PasanWLS/PC-Oscilloscope/Analog Front-end 3D view.png

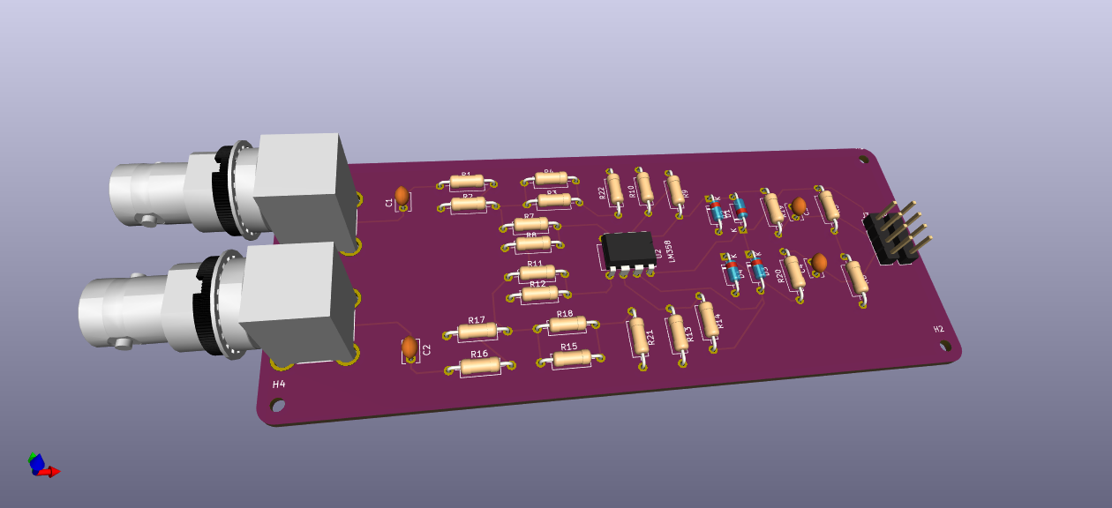
Analog Front-end 3D view.png
