PasanWLS/PC-Oscilloscope/Main PCB 3D view.png

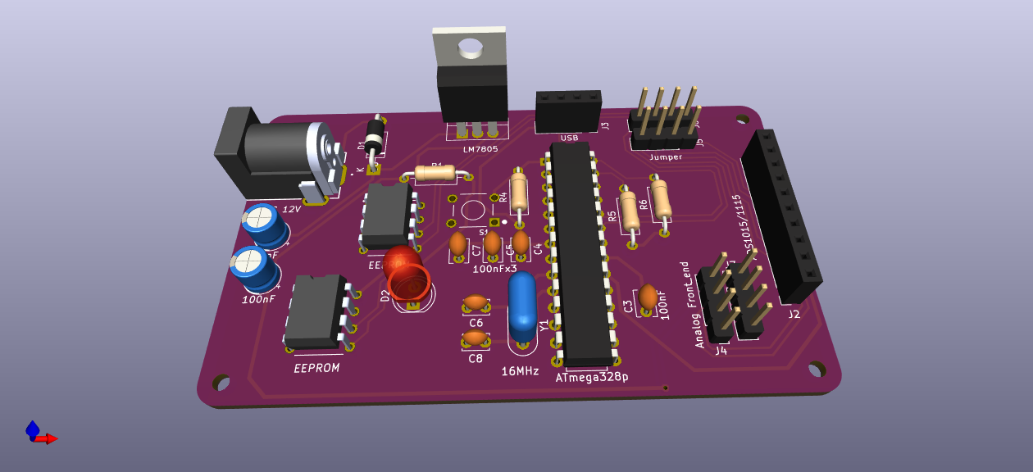
Main PCB 3D view.png
