PasanWLS/PC-Oscilloscope/README.md

# PC-Oscilloscope
PC Oscilloscope designing
this is our 3rd year final project, pc oscilloscope
