PasanWLS/PC-Oscilloscope/Ana;og Front-end 2D.png

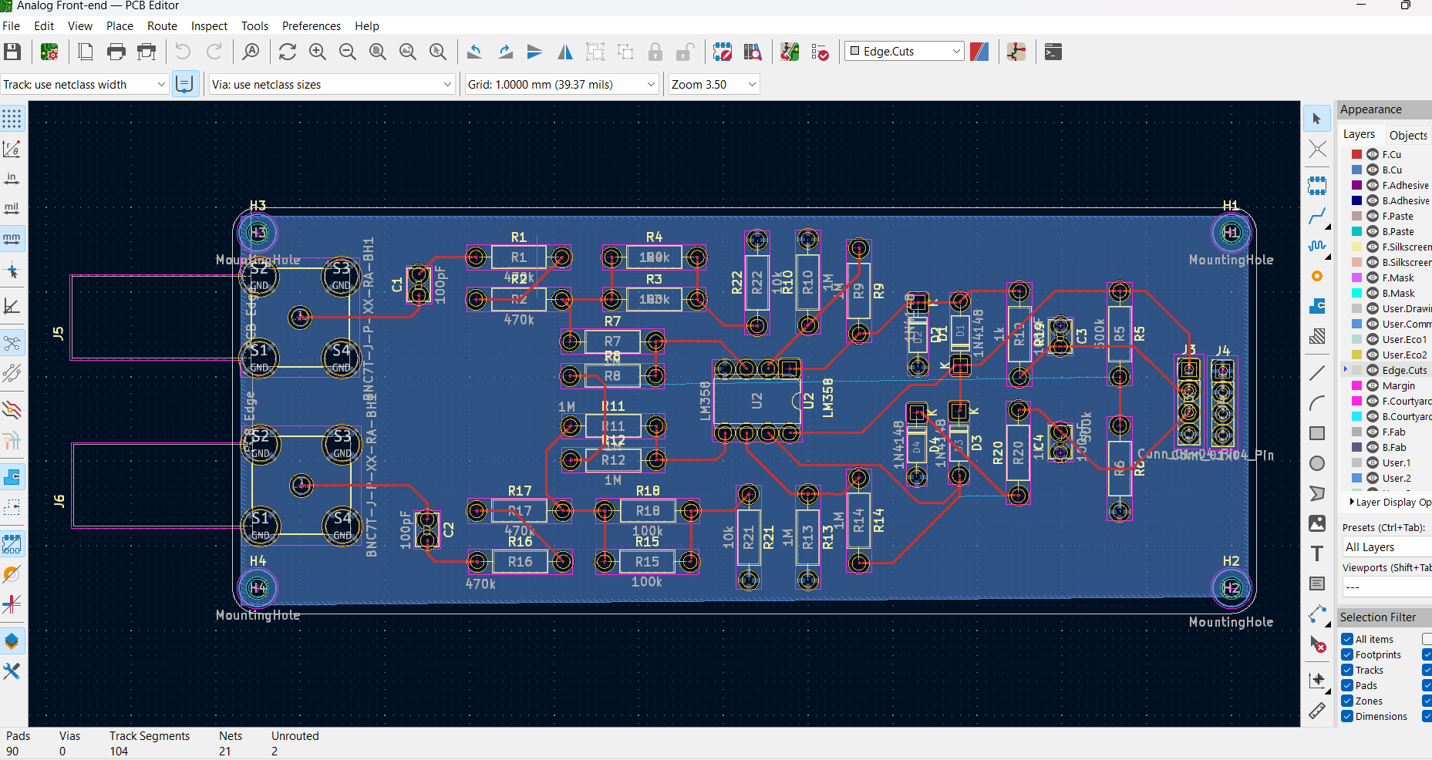
Ana;og Front-end 2D.png
