PasanWLS/PC-Oscilloscope/Analog Front-end Schematic Diagram.jpg

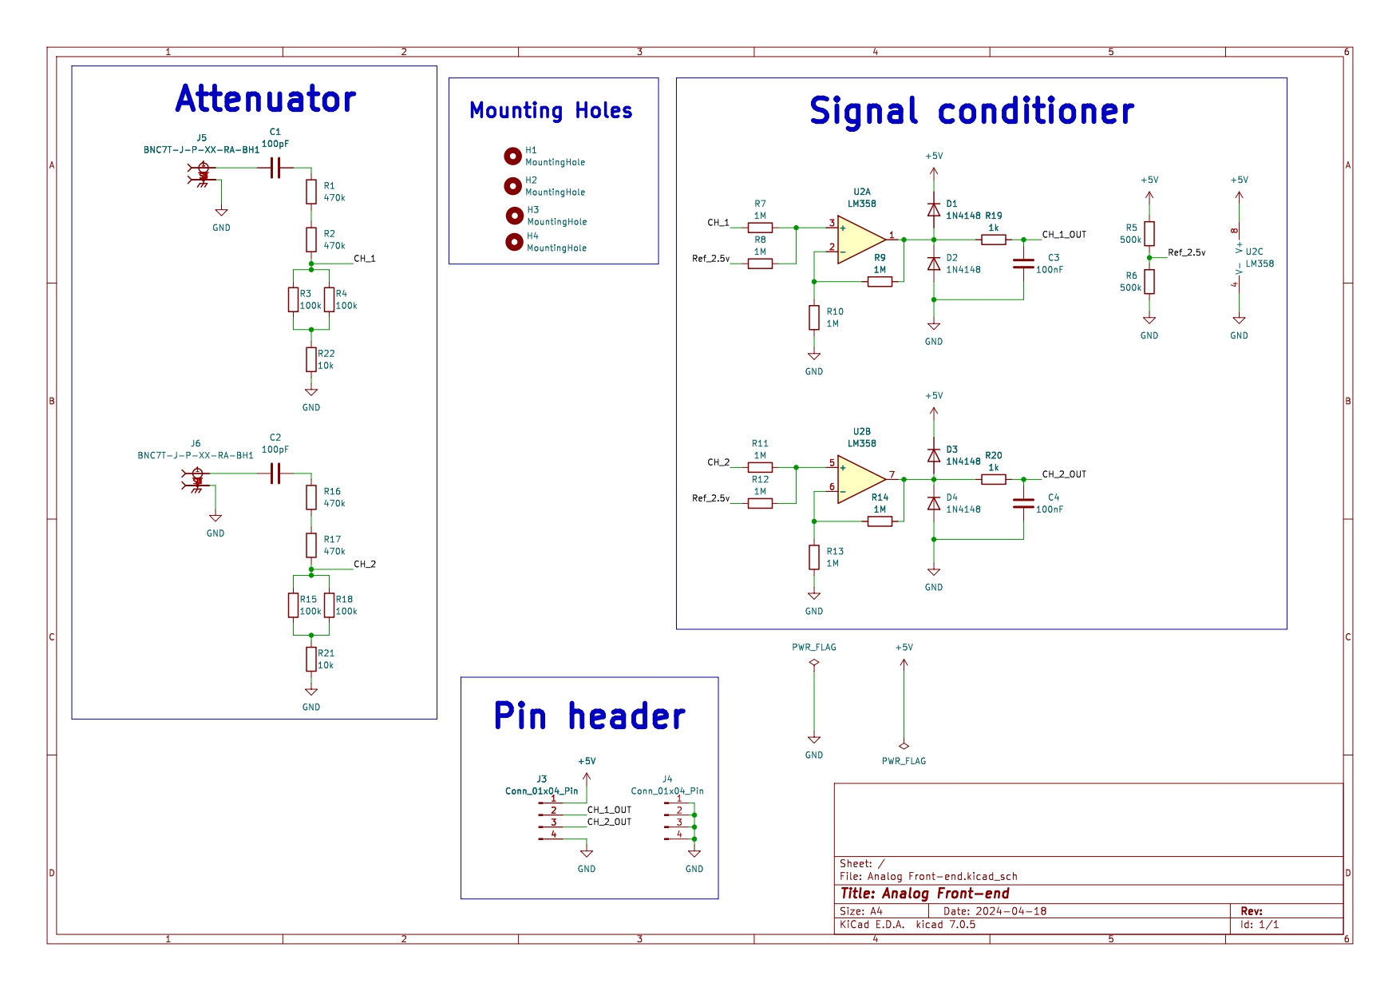
Analog Front-end Schematic Diagram.jpg
