PasanWLS/PC-Oscilloscope/Main PCB Schematic Diagram.jpg

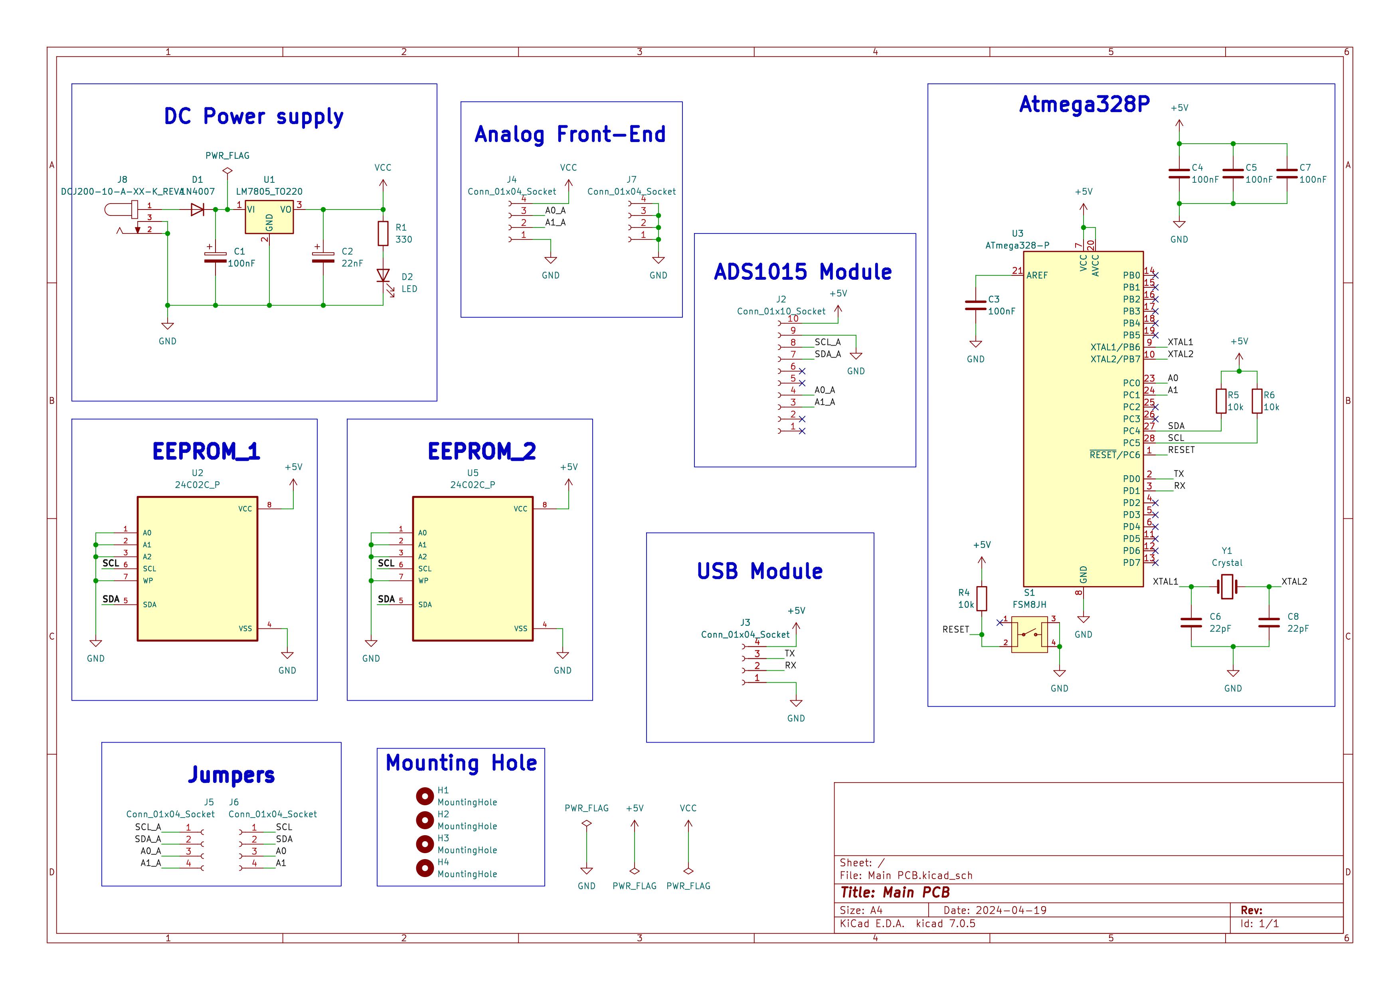
Main PCB Schematic Diagram.jpg
