PasanWLS/PC-Oscilloscope/Main PCB_2D.png

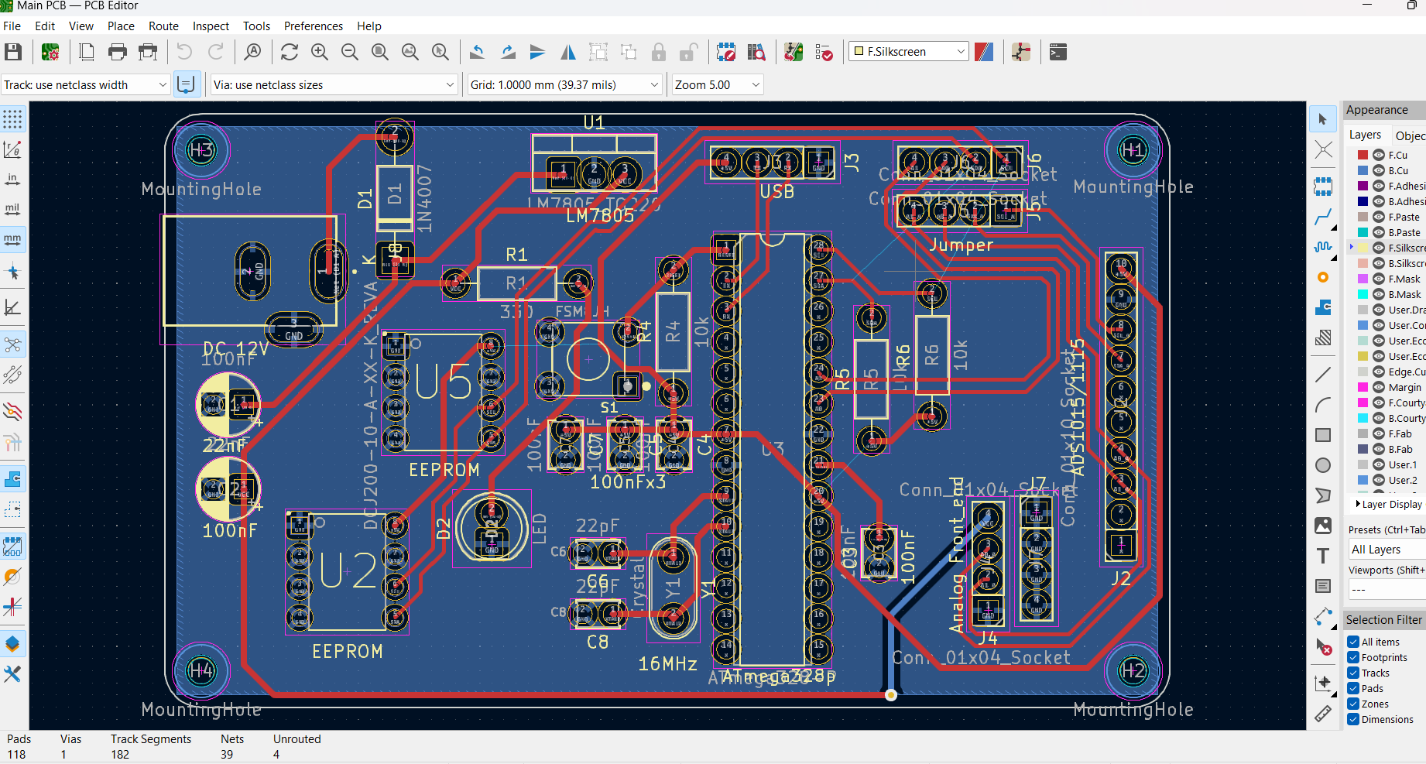
Main PCB_2D.png
