PasanWLS/PC-Oscilloscope/PC Application GUI.JPG

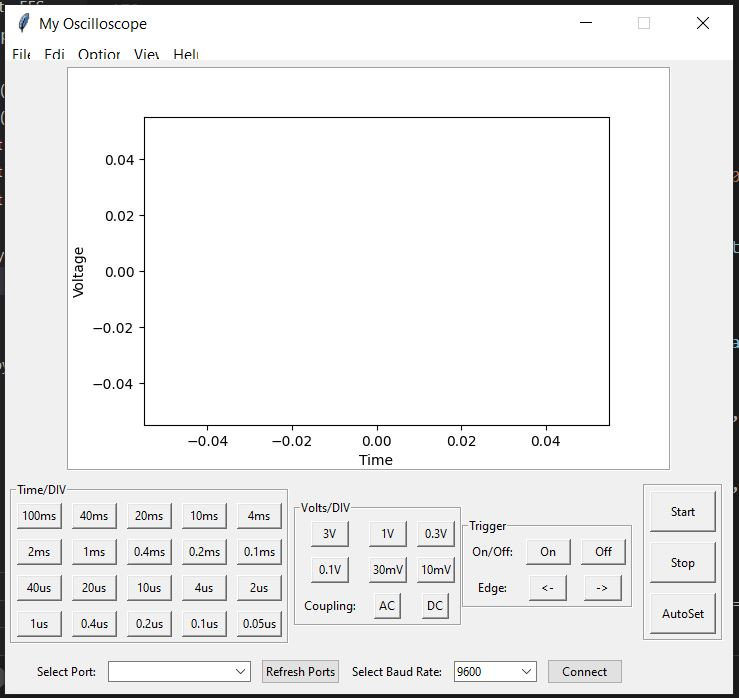
PC Application GUI.JPG
