PasanWLS/PC-Oscilloscope/Footprint/24C02C_P/24C02C_P.STEP

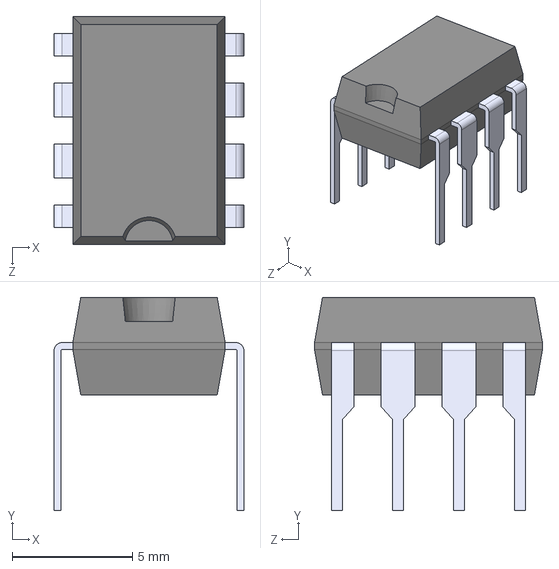
[picture p8: CAD file, 2024-06-17]
Footprint/24C02C_P/24C02C_P.STEP
7.91 x 8.89 x 9.50 mm
