PasanWLS/PC-Oscilloscope/Footprint/BNC7T-J-P-XX-RA-BH1/BNC7T-J-P-HN-RA-BH1.stp

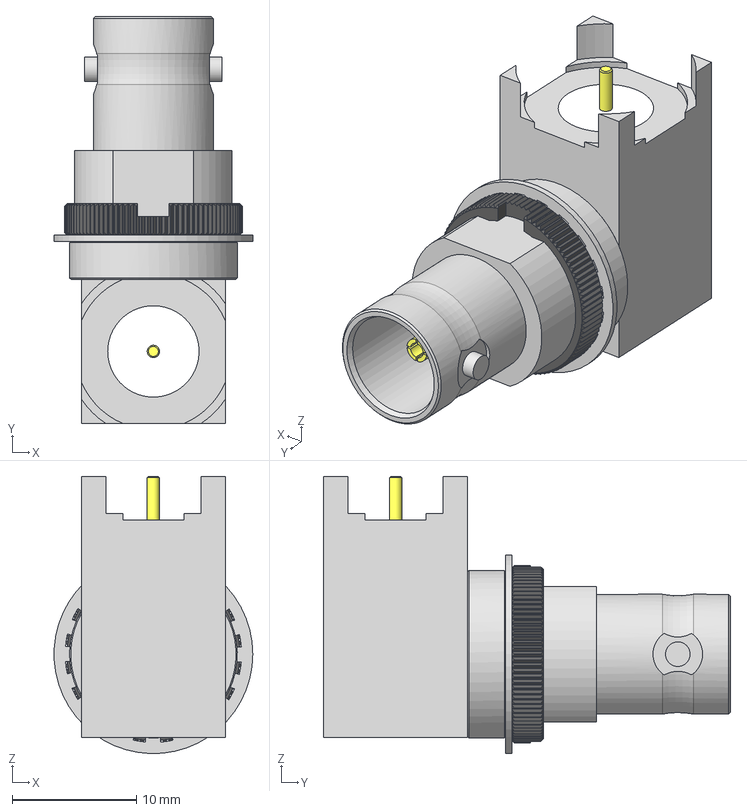
[picture p9: CAD file, 2024-06-17]
Footprint/BNC7T-J-P-XX-RA-BH1/BNC7T-J-P-HN-RA-BH1.stp
16.0 x 32.8 x 22.3 mm
BNC7T-G-P-HN-RA-BH1_s
BNC7T-G-P-HN-RA-BH1_i
BNC7T-G-P-HN-RA-BH1_p
BNC7T-G-P-HN-RA-BH1_w
BNC7T-G-P-HN-RA-BH1_n
