PasanWLS/PC-Oscilloscope/Footprint/DCJ200-10-A-XX-K_REVA/DCJ200-10-A-K1-K--3DModel-STEP-740395.STEP

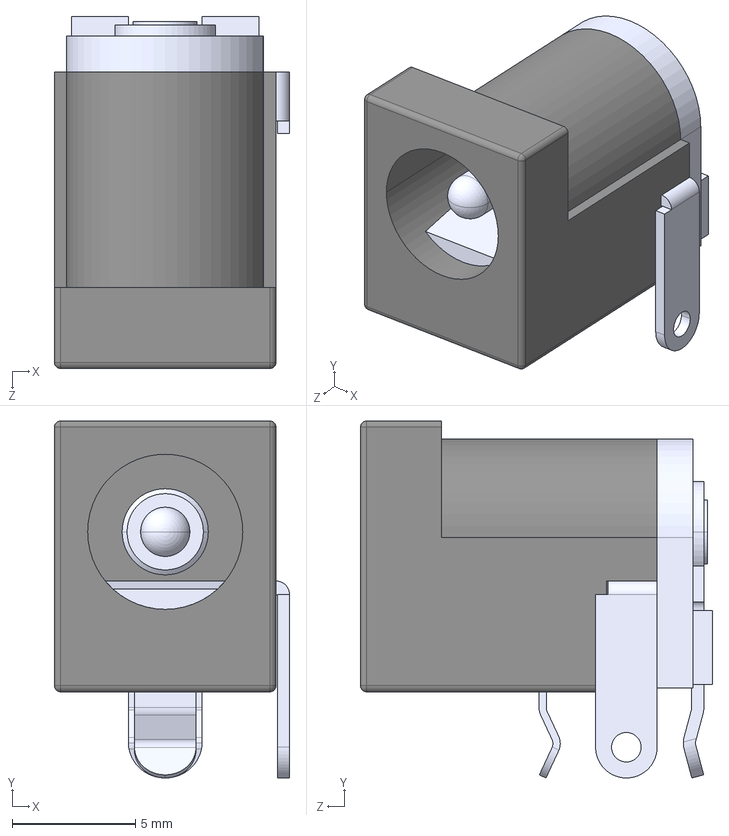
[picture p10: CAD file, 2024-06-17]
Footprint/DCJ200-10-A-XX-K_REVA/DCJ200-10-A-K1-K--3DModel-STEP-740395.STEP
9.55 x 14.5 x 14.3 mm
