PasanWLS/PC-Oscilloscope/Oscilloscope/Analog Front-end/Analog Front-end.kicad_pcb

## KiCad design Oscilloscope/Analog Front-end/Analog Front-end.kicad_pcb (2024-06-17)

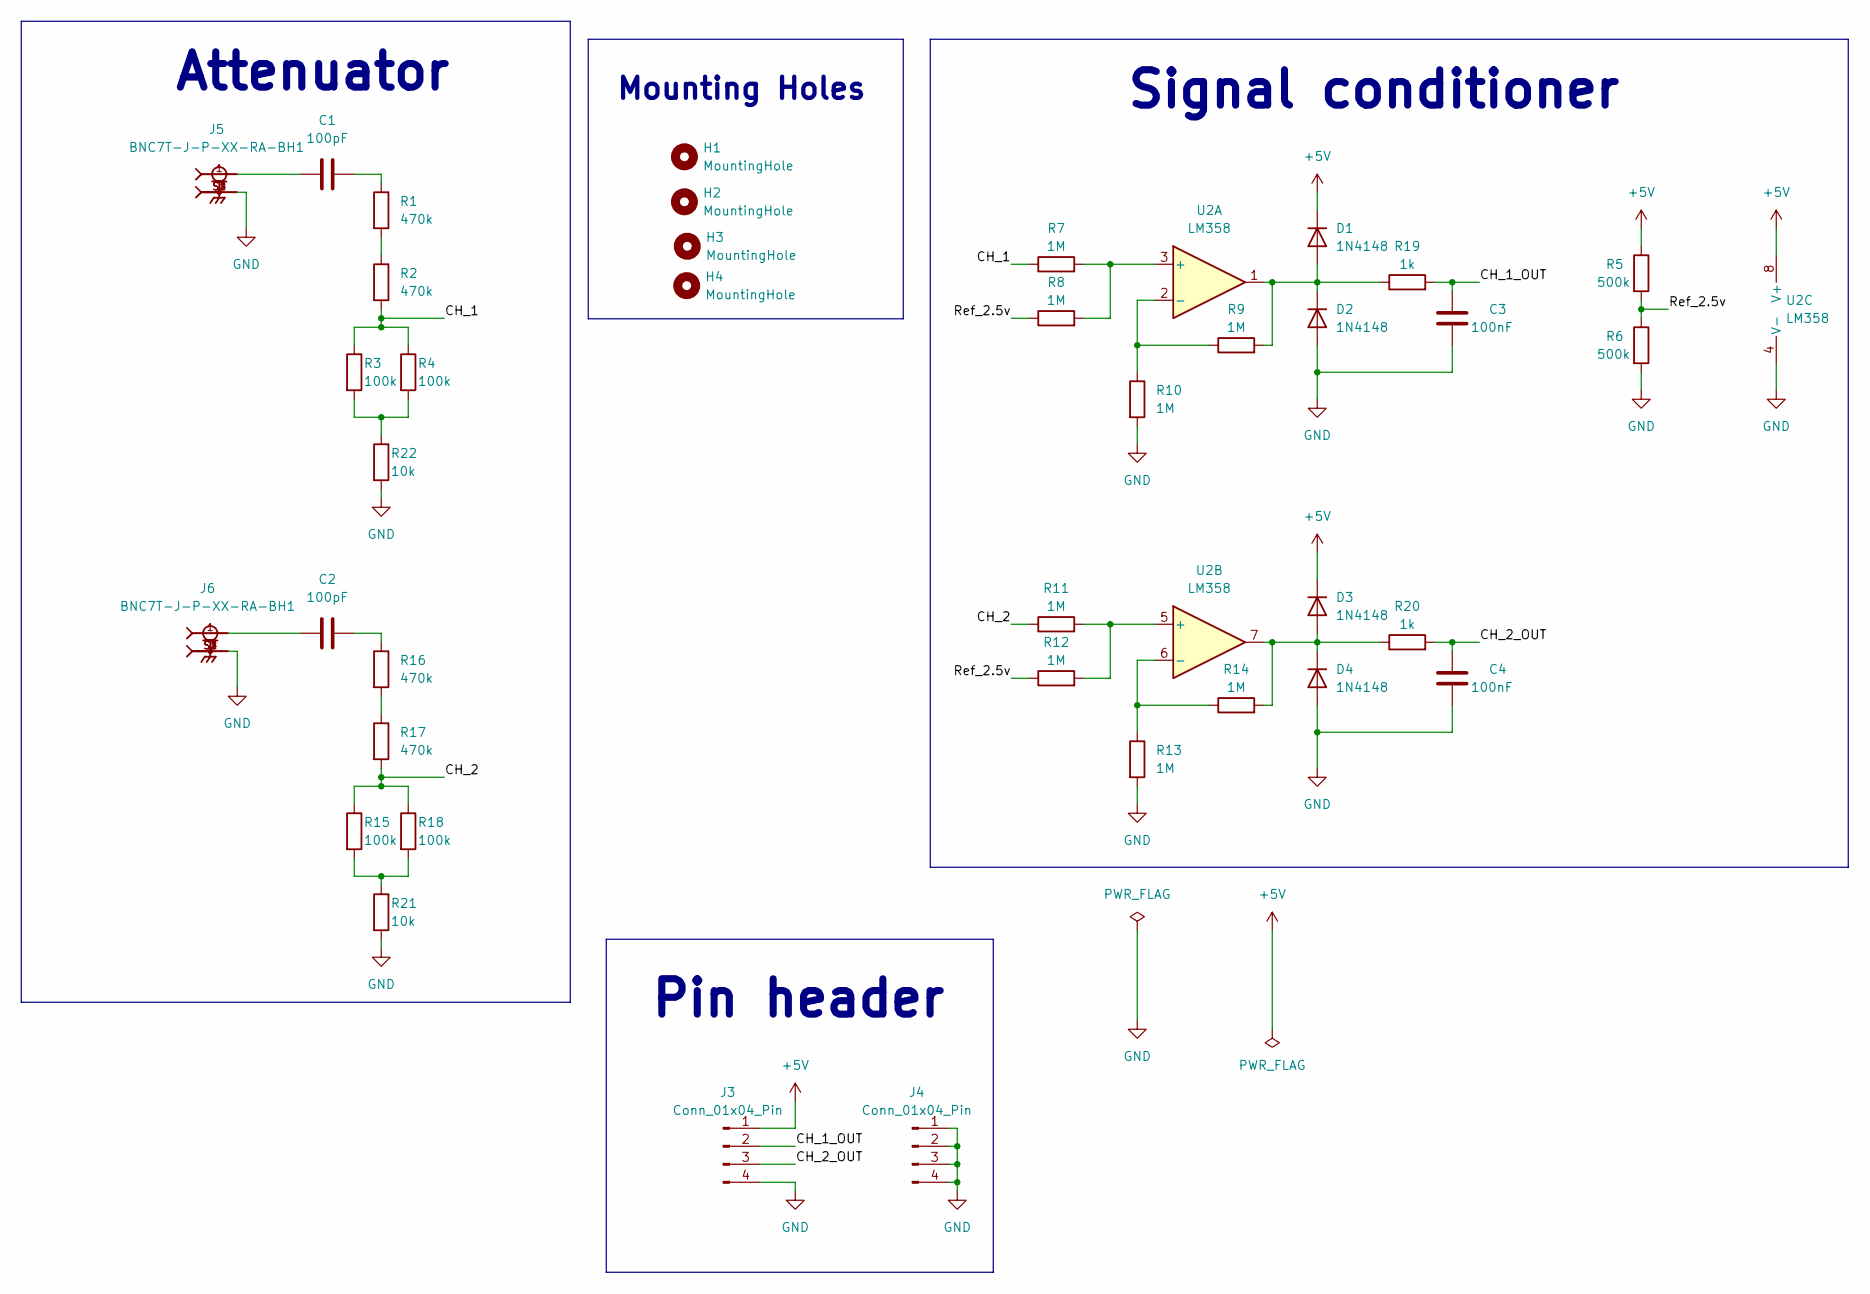
[picture p11: schematic Analog Front-end.kicad_sch]

Parts:
C1, C2: 100pF; C_Disc_D3.8mm_W2.6mm_P2.50mm
C3, C4: 100nF; C_Disc_D3.8mm_W2.6mm_P2.50mm
D1, D2, D3, D4: 1N4148; D_DO-35_SOD27_P7.62mm_Horizontal
H1, H2, H3, H4: MountingHole; MountingHole_2.2mm_M2
J3, J4: Conn_01x04_Pin; PinHeader_1x04_P2.54mm_Vertical
J5, J6: BNC7T-J-P-XX-RA-BH1; SAMTEC_BNC7T-J-P-XX-RA-BH1; PARTREV G
R1, R2, R16, R17: 470k; R_Axial_DIN0207_L6.3mm_D2.5mm_P10.16mm_Horizontal
R3, R4, R15, R18: 100k; R_Axial_DIN0207_L6.3mm_D2.5mm_P10.16mm_Horizontal
R5, R6: 500k; R_Axial_DIN0207_L6.3mm_D2.5mm_P10.16mm_Horizontal
R7, R8, R9, R10, R11, R12, R13, R14: 1M; R_Axial_DIN0207_L6.3mm_D2.5mm_P10.16mm_Horizontal
R19, R20: 1k; R_Axial_DIN0207_L6.3mm_D2.5mm_P10.16mm_Horizontal
R21, R22: 10k; R_Axial_DIN0207_L6.3mm_D2.5mm_P10.16mm_Horizontal
U2: LM358; DIP-8_W7.62mm

Connections:
+5V: D1.1 (K), D3.1 (K), J3.1, R5.1, U2.8 (V+)
/CH_1: R2.2, R3.1, R4.1, R7.1
/CH_1_OUT: C3.2, J3.2, R19.2
/CH_2: R11.1, R15.1, R17.2, R18.1
/CH_2_OUT: C4.2, J3.3, R20.2
/Ref_2.5v: R5.2, R6.1, R8.1, R12.1
GND: C3.1, C4.1, D2.2 (A), D4.2 (A), J3.4, J4.1, J4.2, J4.3, J4.4, J5.S1, J5.S2, J5.S3, J5.S4, J6.S1, J6.S2, J6.S3, J6.S4, R6.2, R10.2, R13.2, R21.2, R22.2, U2.4 (V-)
unnamed: C1.1, J5.1
unnamed: C1.2, R1.1
unnamed: C2.1, J6.1
unnamed: C2.2, R16.1
unnamed: D1.2 (A), D2.1 (K), R9.2, R19.1, U2.1
unnamed: D3.2 (A), D4.1 (K), R14.2, R20.1, U2.7
unnamed: R1.2, R2.1
unnamed: R15.2, R18.2, R21.1
unnamed: R16.2, R17.1
unnamed: R3.2, R4.2, R22.1
unnamed: R7.2, R8.2, U2.3 (+)
unnamed: R9.1, R10.1, U2.2 (-)
unnamed: R11.2, R12.2, U2.5 (+)
unnamed: R13.1, R14.1, U2.6 (-)

Notes on the sheet:
Mounting Holes
Signal conditioner
Attenuator
Pin header

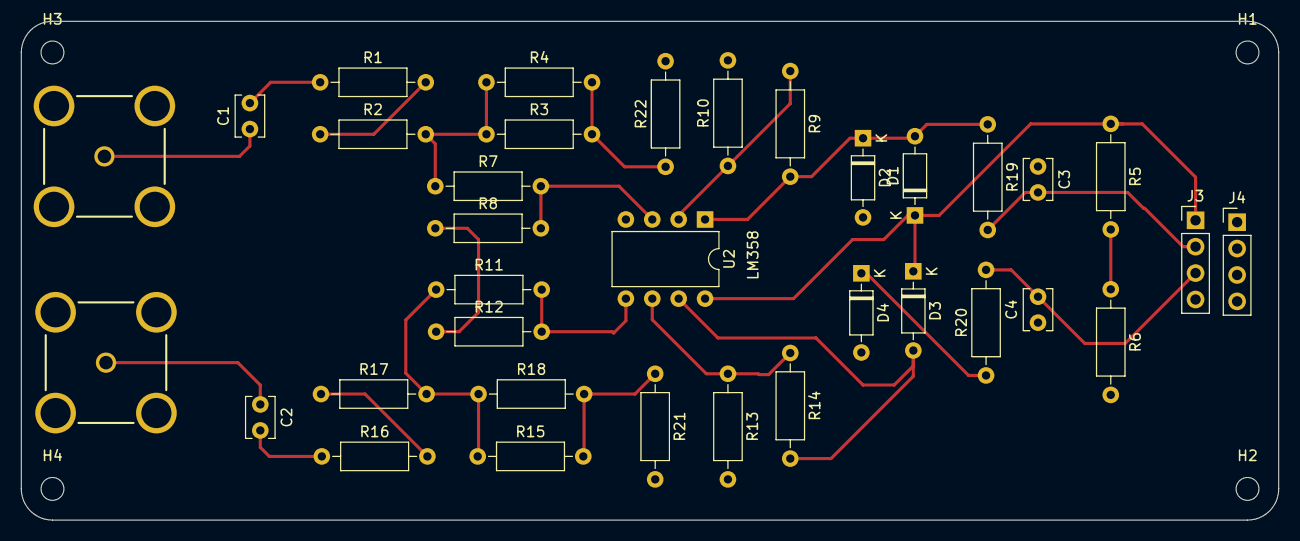
[picture p12: board Analog Front-end.kicad_pcb from above]

Board: 2 copper layers, 121.0 x 48.0 mm, 39 parts (0 on the bottom side), 21 nets.
