PasanWLS/PC-Oscilloscope/Oscilloscope/Main PCB/Main PCB.kicad_pcb

## KiCad design Oscilloscope/Main PCB/Main PCB.kicad_pcb (2024-06-17)

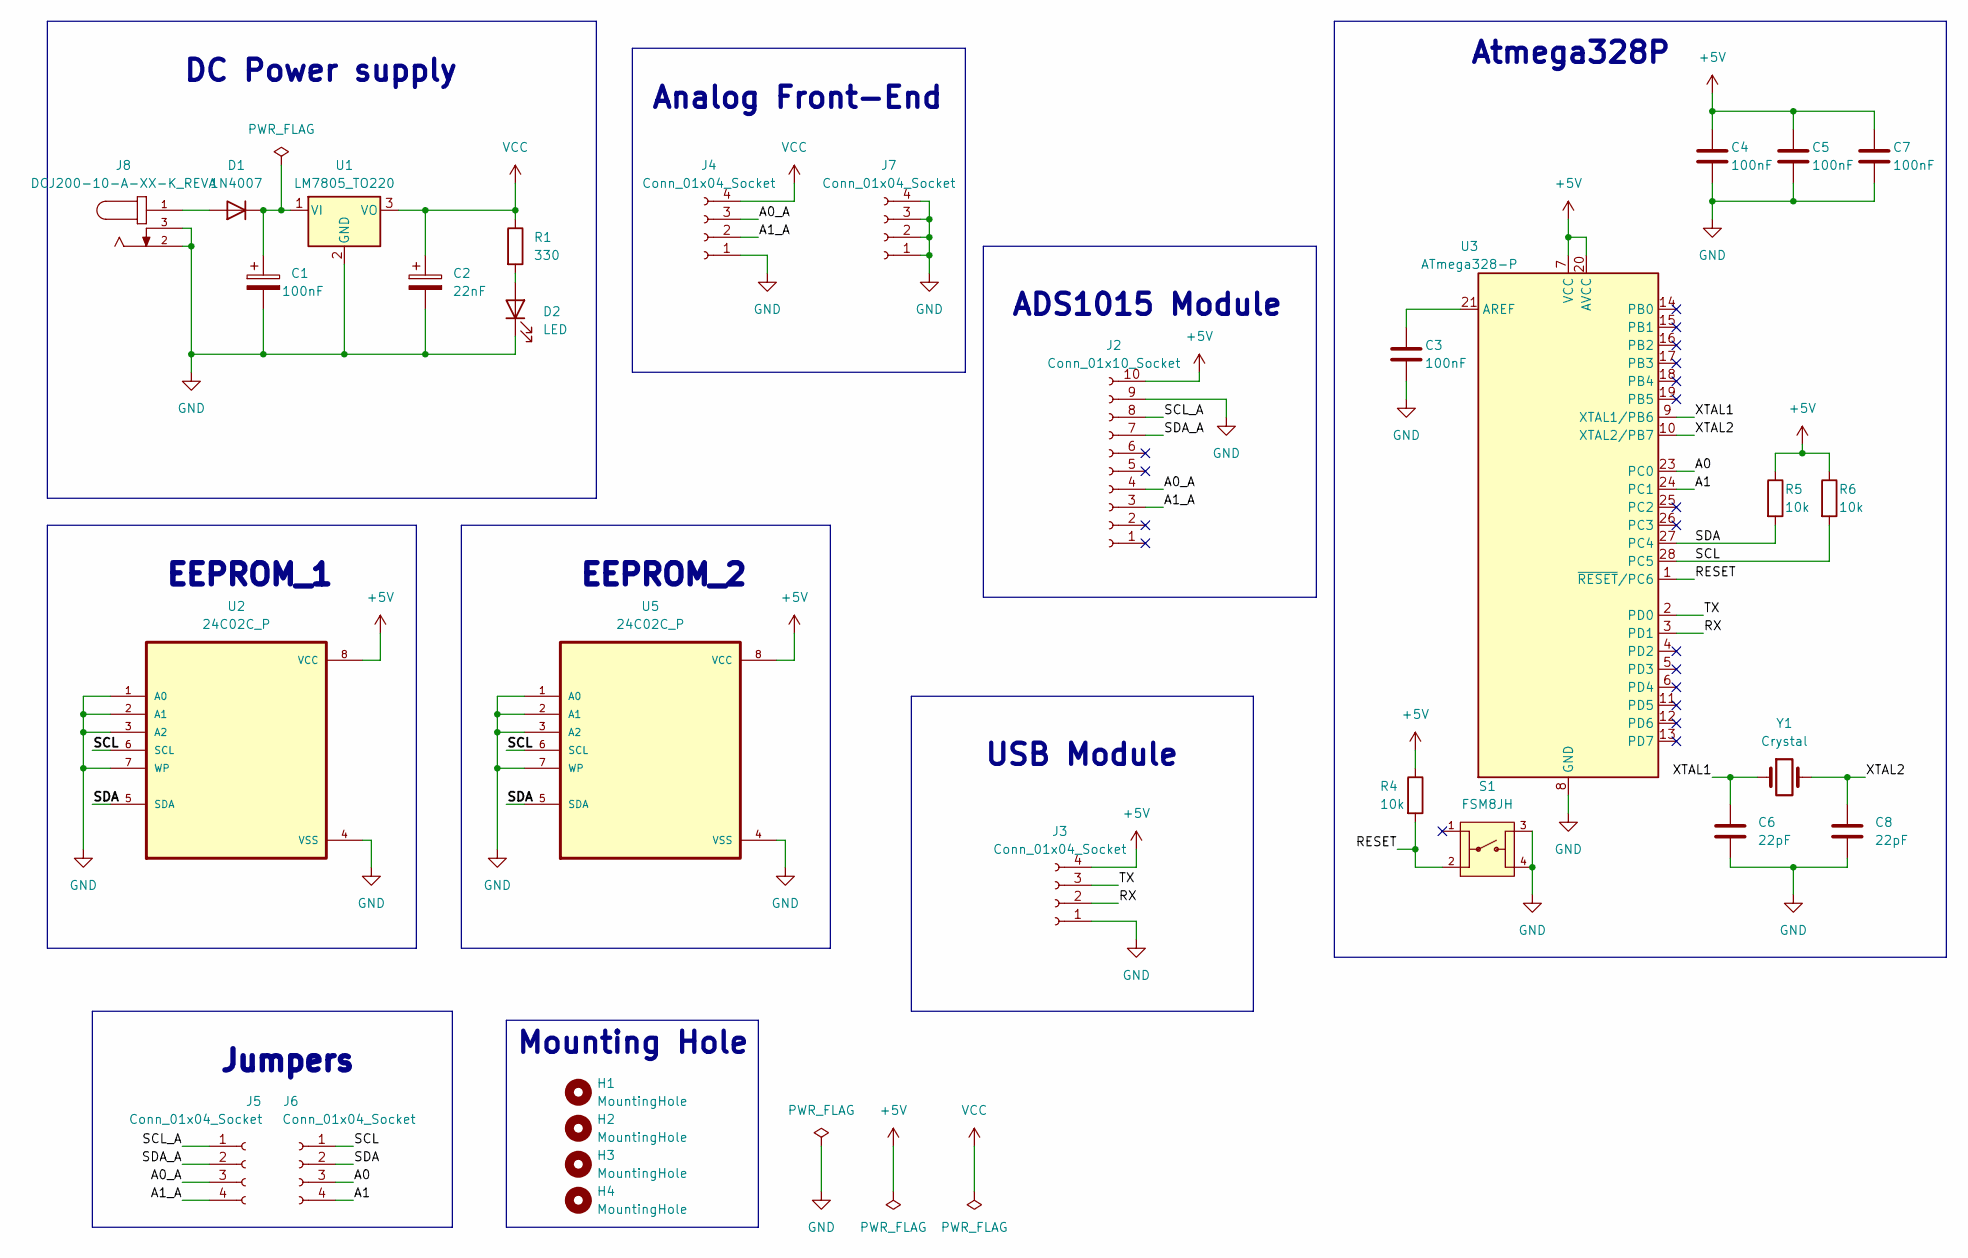
[picture p13: schematic Main PCB.kicad_sch]

Parts:
C1: 100nF; CP_Radial_D5.0mm_P2.50mm
C2: 22nF; CP_Radial_D5.0mm_P2.50mm
C3, C4, C5, C7: 100nF; C_Disc_D3.8mm_W2.6mm_P2.50mm
C6, C8: 22pF; C_Disc_D3.4mm_W2.1mm_P2.50mm
D1: 1N4007; D_DO-41_SOD81_P10.16mm_Horizontal
D2: LED; LED_D5.0mm
H1, H2, H3, H4: MountingHole; MountingHole_2.2mm_M2
J2: Conn_01x10_Socket; PinSocket_1x10_P2.54mm_Vertical
J3: Conn_01x04_Socket; PinSocket_1x04_P2.54mm_Vertical
J4, J5, J6, J7: Conn_01x04_Socket; PinHeader_1x04_P2.54mm_Vertical
J8: DCJ200-10-A-XX-K_REVA; GCT_DCJ200-10-A-XX-K_REVA; PARTREV A
R1: 330; R_Axial_DIN0207_L6.3mm_D2.5mm_P10.16mm_Horizontal
R4, R5, R6: 10k; R_Axial_DIN0207_L6.3mm_D2.5mm_P10.16mm_Horizontal
S1: FSM8JH; SW_FSM8JH; PARTREV C10
U1: LM7805_TO220; TO-220-3_Vertical
U2, U5: 24C02C_P; DIP787W46P254L927H533Q8
U3: ATmega328-P; DIP-28_W7.62mm
Y1: Crystal; Resonator-2Pin_W8.0mm_H3.5mm

Connections:
+5V: C4.1, C5.1, C7.1, J2.10, J3.4, R4.1, R5.1, R6.1, U2.8 (VCC), U3.7 (VCC), U3.20 (AVCC), U5.8 (VCC)
/A0: J6.3, U3.23 (PC0)
/A0_A: J2.4, J4.3, J5.3
/A1: J6.4, U3.24 (PC1)
/A1_A: J2.3, J4.2, J5.4
/RESET: R4.2, S1.2, U3.1 (~RESET/PC6)
/RX: J3.2, U3.3 (PD1)
/SCL: J6.1, R6.2, U2.6 (SCL), U3.28 (PC5), U5.6 (SCL)
/SCL_A: J2.8, J5.1
/SDA: J6.2, R5.2, U2.5 (SDA), U3.27 (PC4), U5.5 (SDA)
/SDA_A: J2.7, J5.2
/TX: J3.3, U3.2 (PD0)
/XTAL1: C6.1, U3.9 (XTAL1/PB6), Y1.1
/XTAL2: C8.1, U3.10 (XTAL2/PB7), Y1.2
GND: C1.2, C2.2, C3.2, C4.2, C5.2, C6.2, C7.2, C8.2, D2.1 (K), J2.9, J3.1, J4.1, J7.1, J7.2, J7.3, J7.4, J8.2, J8.3, S1.3, S1.4, U1.2 (GND), U2.1 (A0), U2.2 (A1), U2.3 (A2), U2.4 (VSS), U2.7 (WP), U3.8 (GND), U3.22 (GND), U5.1 (A0), U5.2 (A1), U5.3 (A2), U5.4 (VSS), U5.7 (WP)
unnamed: D1.2 (A), J8.1
unnamed: C1.1, D1.1 (K), U1.1 (VI)
unnamed: D2.2 (A), R1.2
unnamed: C3.1, U3.21 (AREF)
VCC: C2.1, J4.4, R1.1, U1.3 (VO)

Notes on the sheet:
EEPROM_2
Analog Front-End
Atmega328P
USB Module
DC Power supply
EEPROM_1
Jumpers
ADS1015 Module
Mounting Hole

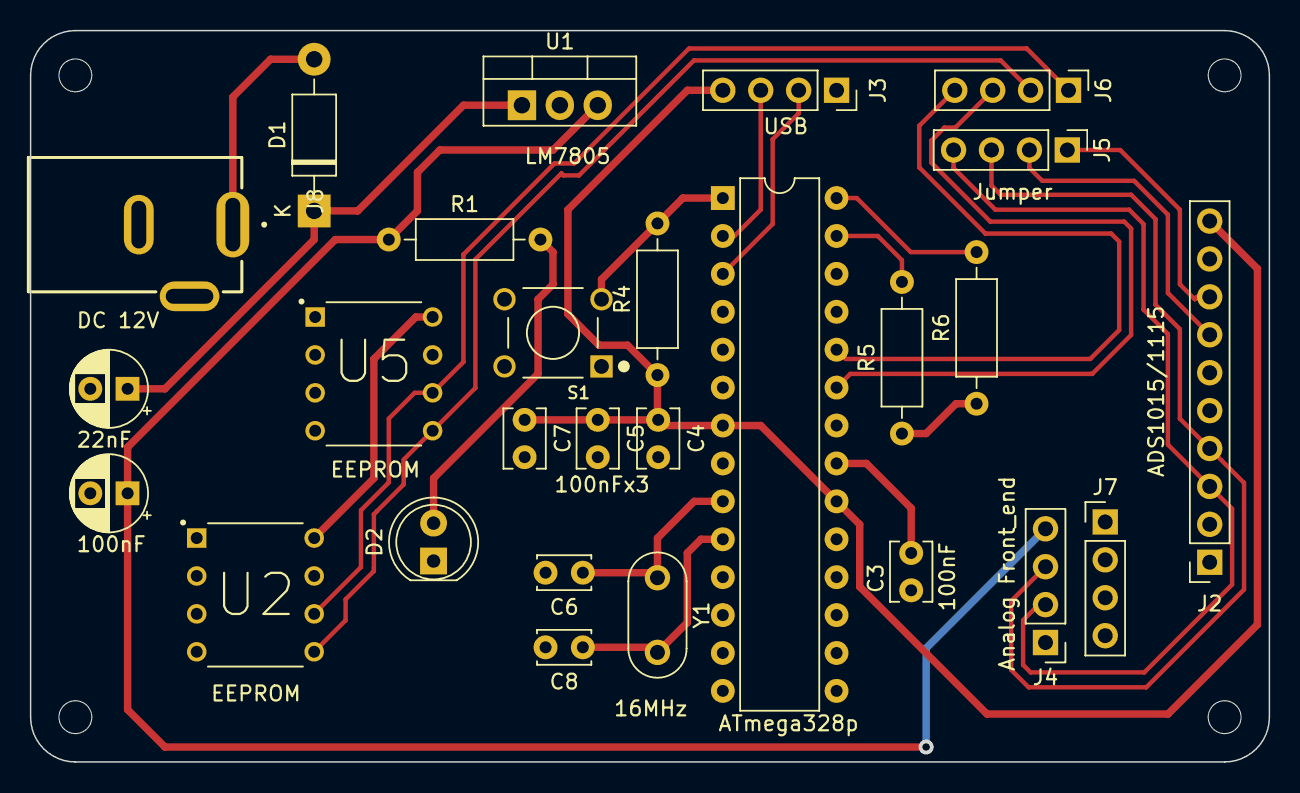
[picture p14: board Main PCB.kicad_pcb from above]

Board: 2 copper layers, 83.0 x 49.0 mm, 31 parts (0 on the bottom side), 20 nets.
