PasanWLS/PC-Oscilloscope/(notices)

Notices in the files:
Footprint/BNC7T-J-P-XX-RA-BH1/BNC7T-J-P-XX-RA-BH1.step:
author */ ('License CC BY-ND 4.0'),
